kraftb/OptoMouseDetector/OptoMouseDetector-schematic.pdf

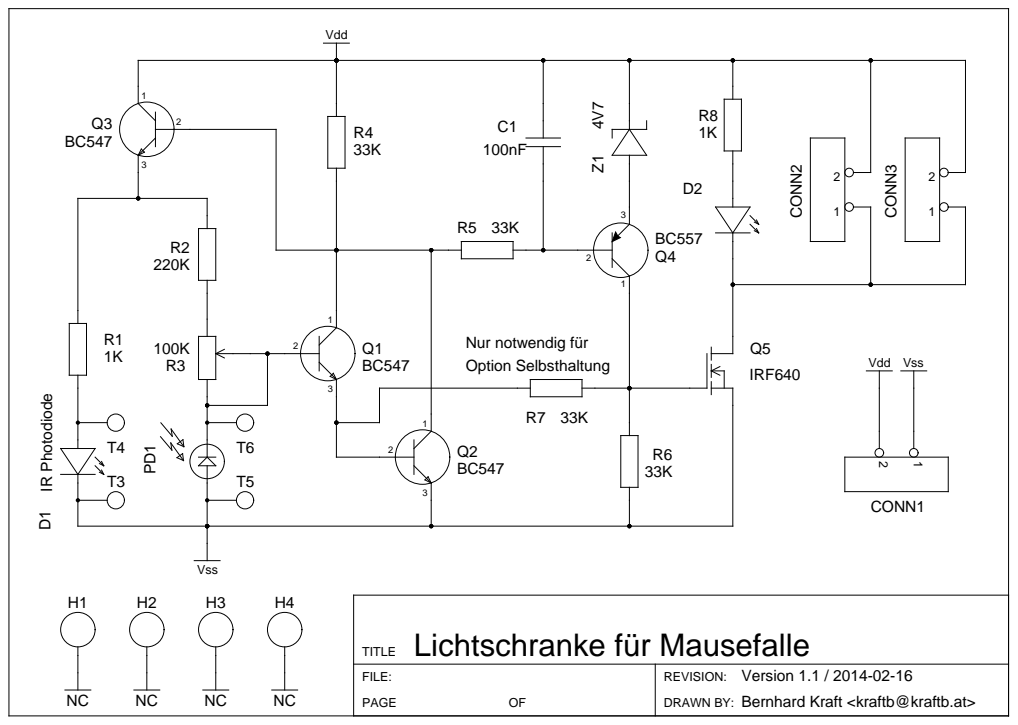
[picture p1: page 1]

Version 1.1 / 2014-02-16
Bernhard Kraft <kraftb@kraftb.at>
