kraftb/OptoMouseDetector/OptoMouseDetector-pcb.pdf

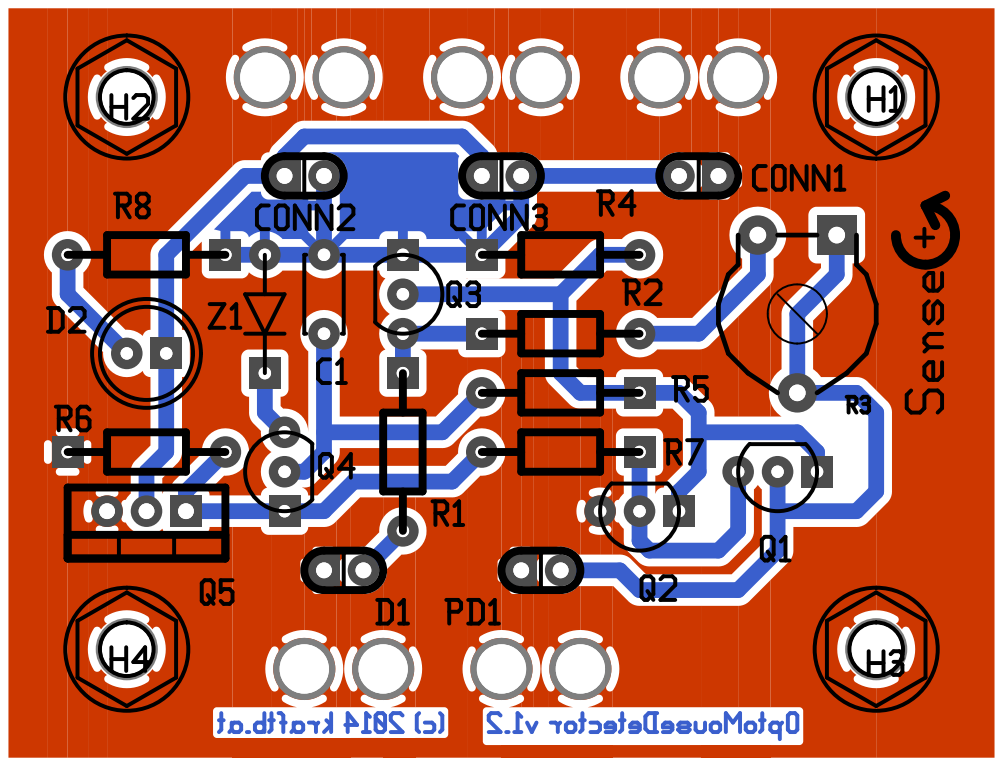
[picture p2: page 1]
