kraftb/OptoMouseDetector/(list of files, drawings)

Other design files:
OptoMouseDetector.pcb
