kraftb/OptoMouseDetector/(commit log)

2014-01-24 [TASK] Initial commit into git
    [OptoMouseDetector.sch]
2014-01-24 [TASK] The package SIP2N didn't exist. Replaced it by SIP2.
    [OptoMouseDetector.sch]
2014-01-24 [TASK] Added symlinks to used packages
    The packages are taken from:
    http://www.luciani.org/geda/pcb/pcb-footprint-list.html
2014-01-24 [TASK] Added first version of PCB file
    [OptoMouseDetector.pcb]
2014-01-25 [TASK] Reconnected the potentiometer to match symbol/footprint
    [OptoMouseDetector.sch]
2014-01-25 [TASK] Routed the PCB
    [OptoMouseDetector.pcb]
2014-01-29 [TASK] Changes to the schematic
    Exchanged the output transistor to a MOSFET.
    Added some custom adapted symbols and created a gafrc to enable
    access to them in gschem.
    Added a transistor which shuts down the IR-LED and IR Photodiode
    after the circuit got enabled (IR beam interrupted) and self hold
    is active. This ensures all devices inside the trap are voltage
    free after activation: This could save a mouse some tremor.
    [OptoMouseDetector.sch]
2014-01-29 [TASK] Added new/changed parts and routed the PCB
    The output transistor got exchanged to a MOSFET, a LED signaling
    the status and a sensor shutdown transistor got added. Placed all
    additional parts and routed the layout.
    [OptoMouseDetector.pcb]
2014-01-29 [TASK] Fine tuned the PCB for printing
    Added copyright and project version labels.
    Added silk screen instructions for potentiometer tuning.
    [OptoMouseDetector.pcb]
2014-02-16 [TASK] Added a line in the 'all' target for doing the sch->pcb converstion
2014-03-16 [TASK] Optimized circuit and added ground plane
    The potentiometer was replaced by a more common non-spindle potentiometer
    which can get adjusted from the top.
    A ground plane was added so only the spacings between traces have to get
    etched. This should save etch solvent.
    [OptoMouseDetector.pcb, OptoMouseDetector.sch]
2014-03-16 [TASK] Created an SVG for etching
    The SVG contains the board twice with a black surrounding box to
    reduce the required amount of etch solvent. The surrounding box
    is separated from the board by a quite thick line which eases
    cutout.
2014-07-18 [TASK] Added PDFs of schematic and PCB for review
